derekbelsky102/kicad/README.md

Kicad cheetsheet: https://silica.io/wp-content/uploads/2018/06/kicad-cheatsheet-landscape.pdf
