derekbelsky102/kicad/hw/designs/stm32_breakout/stm32l_lqfp32/rev0/PDF/stm32l_lqfp32_rev0.pdf

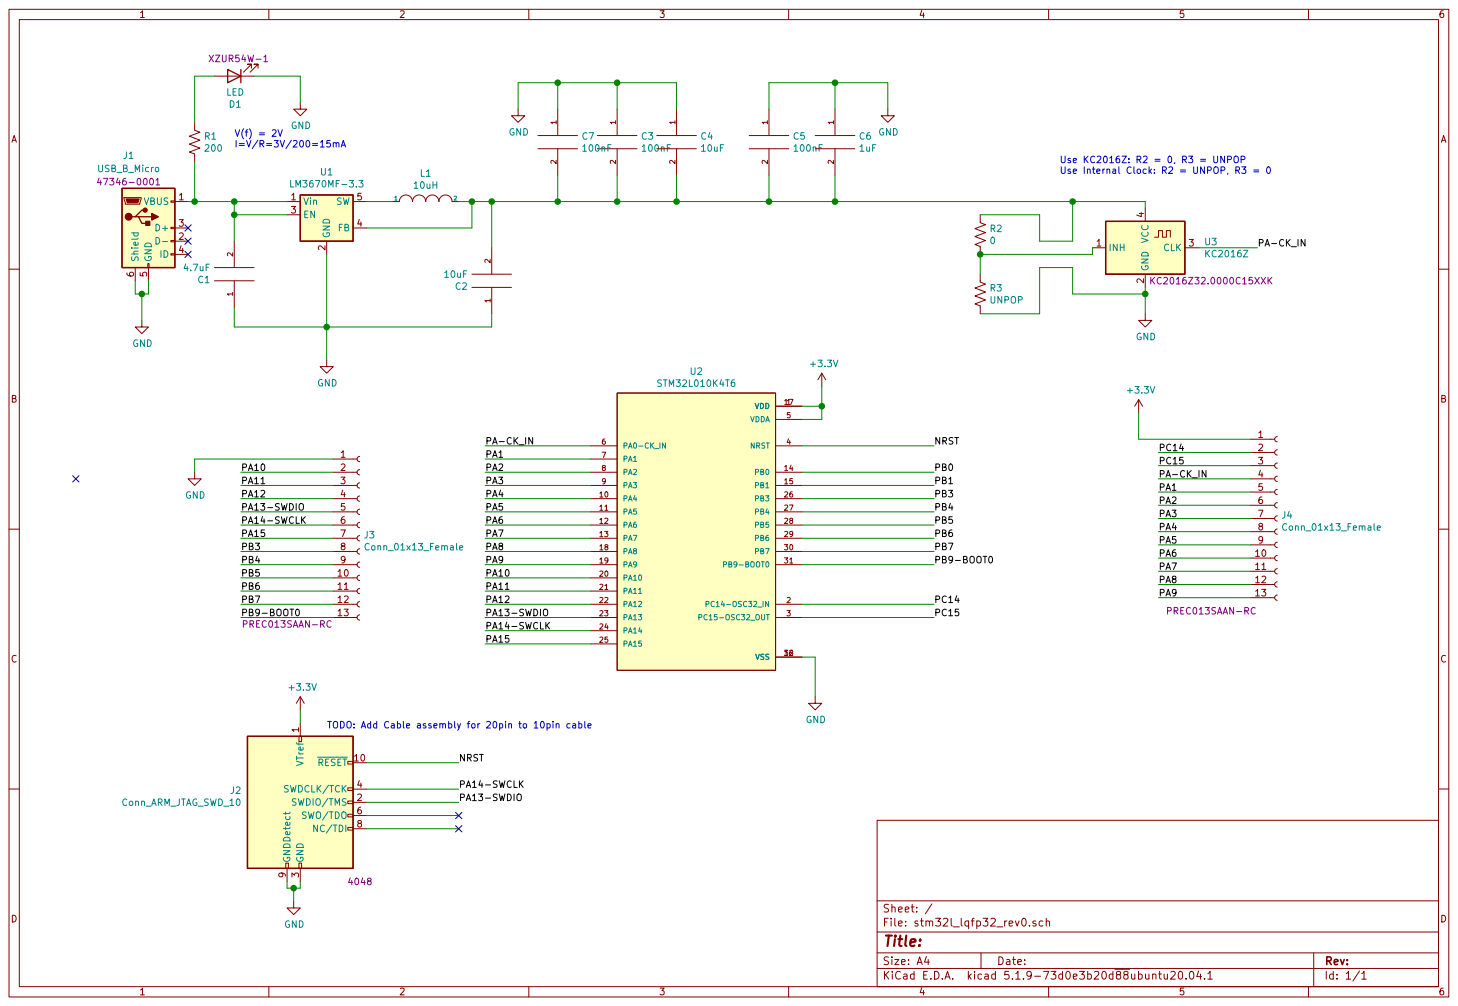
[picture p1: page 1]

TODO: Add Cable assembly for 20pin to 10pin cable

3 SWDCLK/TCK 4 SWO/TDO 6 NC/TDI 8 GNDDetect 9
