derekbelsky102/kicad/(list of files, drawings)

Other design files:
fw/docs/NUCLEO-L452RE_DEV_BOARD/Connectors.SchDoc
fw/docs/NUCLEO-L452RE_DEV_BOARD/MB1136.PcbDoc
fw/docs/NUCLEO-L452RE_DEV_BOARD/MB1136.PrjPCB
fw/docs/NUCLEO-L452RE_DEV_BOARD/MB1136.SchDoc
fw/docs/NUCLEO-L452RE_DEV_BOARD/MB1136.SCHLIB
fw/docs/NUCLEO-L452RE_DEV_BOARD/MCU_64.SchDoc
fw/docs/NUCLEO-L452RE_DEV_BOARD/ST_LINK_V2-1.SCHDOC
