derekbelsky102/kicad/hw/designs/keyboard/keyboard/keyboard.kicad_pcb

## KiCad design hw/designs/keyboard/keyboard/keyboard.kicad_pcb (2022-11-22)

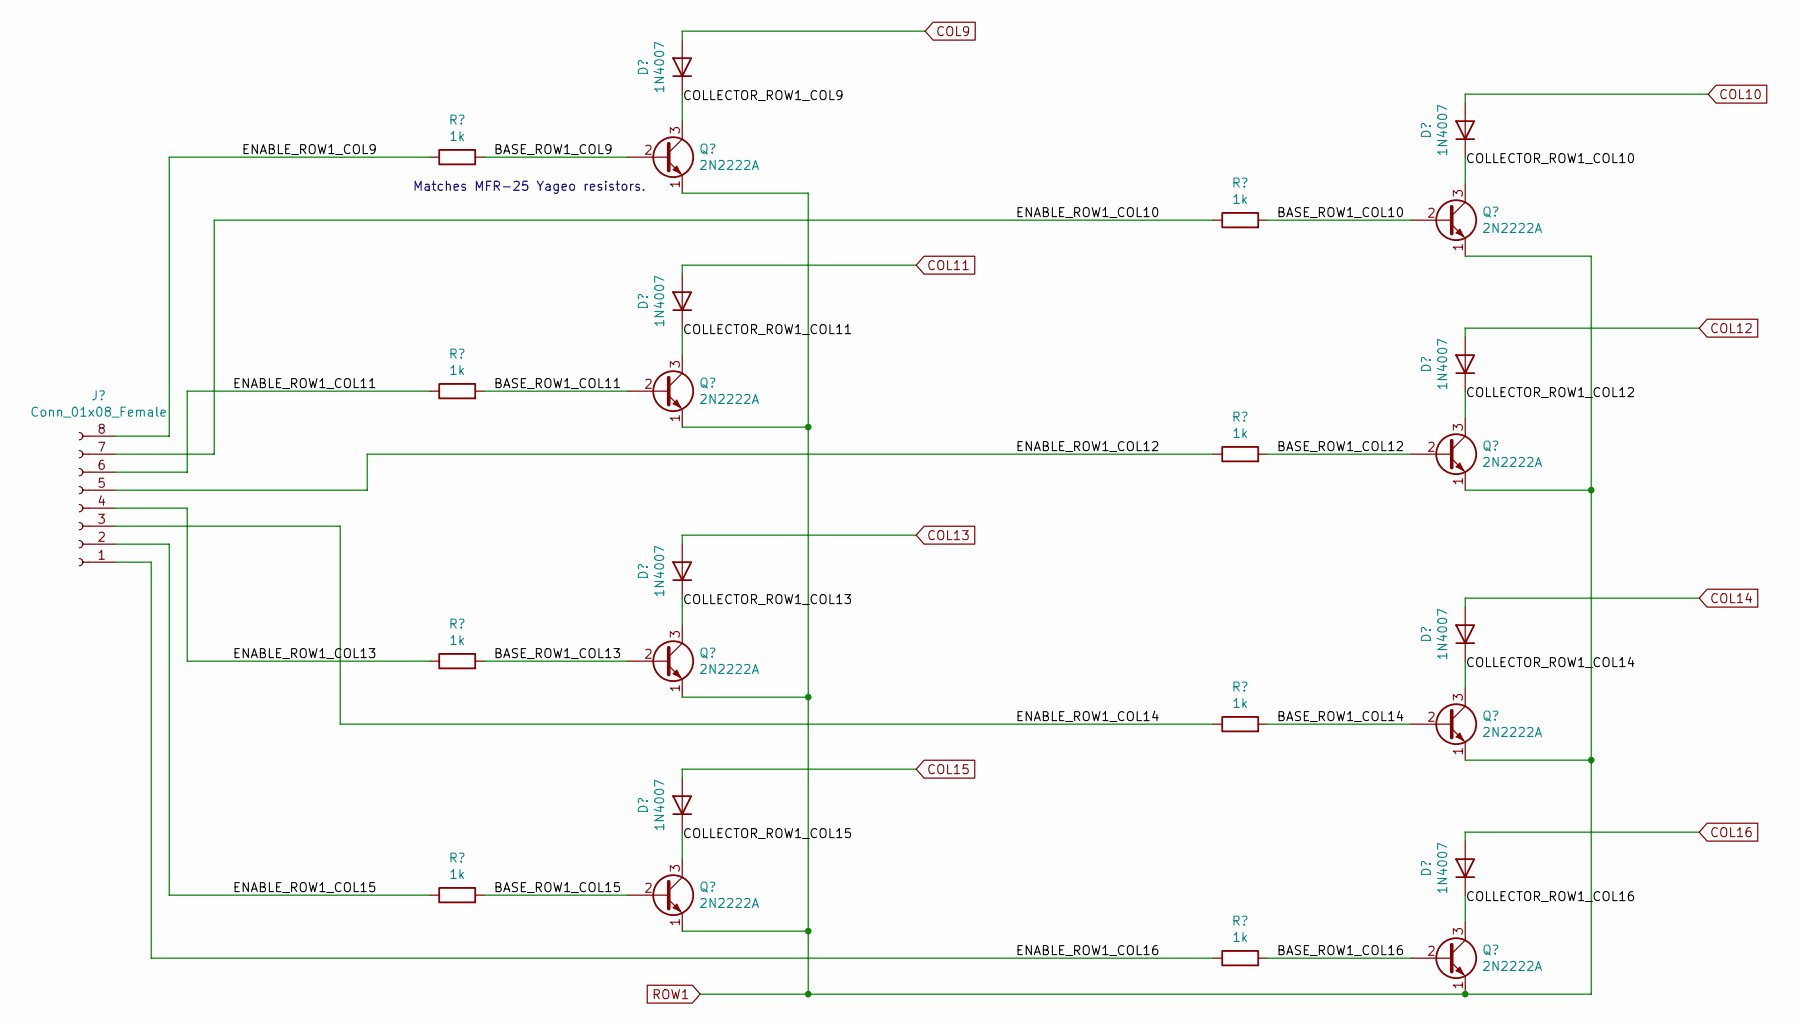
[picture p2: schematic ROW1_COL[9-16].sch]

Parts:
D9, D10, D11, D12, D13, D14, D15, D16: 1N4007; D_DO-41_SOD81_P10.16mm_Horizontal
J2: Conn_01x08_Female; PinSocket_1x08_P2.54mm_Vertical
Q9, Q10, Q11, Q12, Q13, Q14, Q15, Q16: 2N2222A; TO-92_Inline
R9, R10, R11, R12, R13, R14, R15, R16: 1k; R_Axial_DIN0207_L6.3mm_D2.5mm_P10.16mm_Horizontal

Connections:
/ROW1_COL[9-16]/BASE_ROW1_COL9: Q9.2 (B), R9.2
/ROW1_COL[9-16]/BASE_ROW1_COL10: Q13.2 (B), R13.2
/ROW1_COL[9-16]/BASE_ROW1_COL11: Q10.2 (B), R10.2
/ROW1_COL[9-16]/BASE_ROW1_COL12: Q14.2 (B), R14.2
/ROW1_COL[9-16]/BASE_ROW1_COL13: Q11.2 (B), R11.2
/ROW1_COL[9-16]/BASE_ROW1_COL14: Q15.2 (B), R15.2
/ROW1_COL[9-16]/BASE_ROW1_COL15: Q12.2 (B), R12.2
/ROW1_COL[9-16]/BASE_ROW1_COL16: Q16.2 (B), R16.2
/ROW1_COL[9-16]/COLLECTOR_ROW1_COL9: D9.1 (K), Q9.3 (C)
/ROW1_COL[9-16]/COLLECTOR_ROW1_COL10: D13.1 (K), Q13.3 (C)
/ROW1_COL[9-16]/COLLECTOR_ROW1_COL11: D10.1 (K), Q10.3 (C)
/ROW1_COL[9-16]/COLLECTOR_ROW1_COL12: D14.1 (K), Q14.3 (C)
/ROW1_COL[9-16]/COLLECTOR_ROW1_COL13: D11.1 (K), Q11.3 (C)
/ROW1_COL[9-16]/COLLECTOR_ROW1_COL14: D15.1 (K), Q15.3 (C)
/ROW1_COL[9-16]/COLLECTOR_ROW1_COL15: D12.1 (K), Q12.3 (C)
/ROW1_COL[9-16]/COLLECTOR_ROW1_COL16: D16.1 (K), Q16.3 (C)
/ROW1_COL[9-16]/ENABLE_ROW1_COL9: J2.8, R9.1
/ROW1_COL[9-16]/ENABLE_ROW1_COL10: J2.7, R13.1
/ROW1_COL[9-16]/ENABLE_ROW1_COL11: J2.6, R10.1
/ROW1_COL[9-16]/ENABLE_ROW1_COL12: J2.5, R14.1
/ROW1_COL[9-16]/ENABLE_ROW1_COL13: J2.4, R11.1
/ROW1_COL[9-16]/ENABLE_ROW1_COL14: J2.3, R15.1
/ROW1_COL[9-16]/ENABLE_ROW1_COL15: J2.2, R12.1
/ROW1_COL[9-16]/ENABLE_ROW1_COL16: J2.1, R16.1
COL9: D9.2 (A)
COL10: D13.2 (A)
COL11: D10.2 (A)
COL12: D14.2 (A)
COL13: D11.2 (A)
COL14: D15.2 (A)
COL15: D12.2 (A)
COL16: D16.2 (A)
ROW1: Q9.1 (E), Q10.1 (E), Q11.1 (E), Q12.1 (E), Q13.1 (E), Q14.1 (E), Q15.1 (E), Q16.1 (E); also elsewhere on the board

Notes on the sheet:
Matches MFR-25 Yageo resistors.

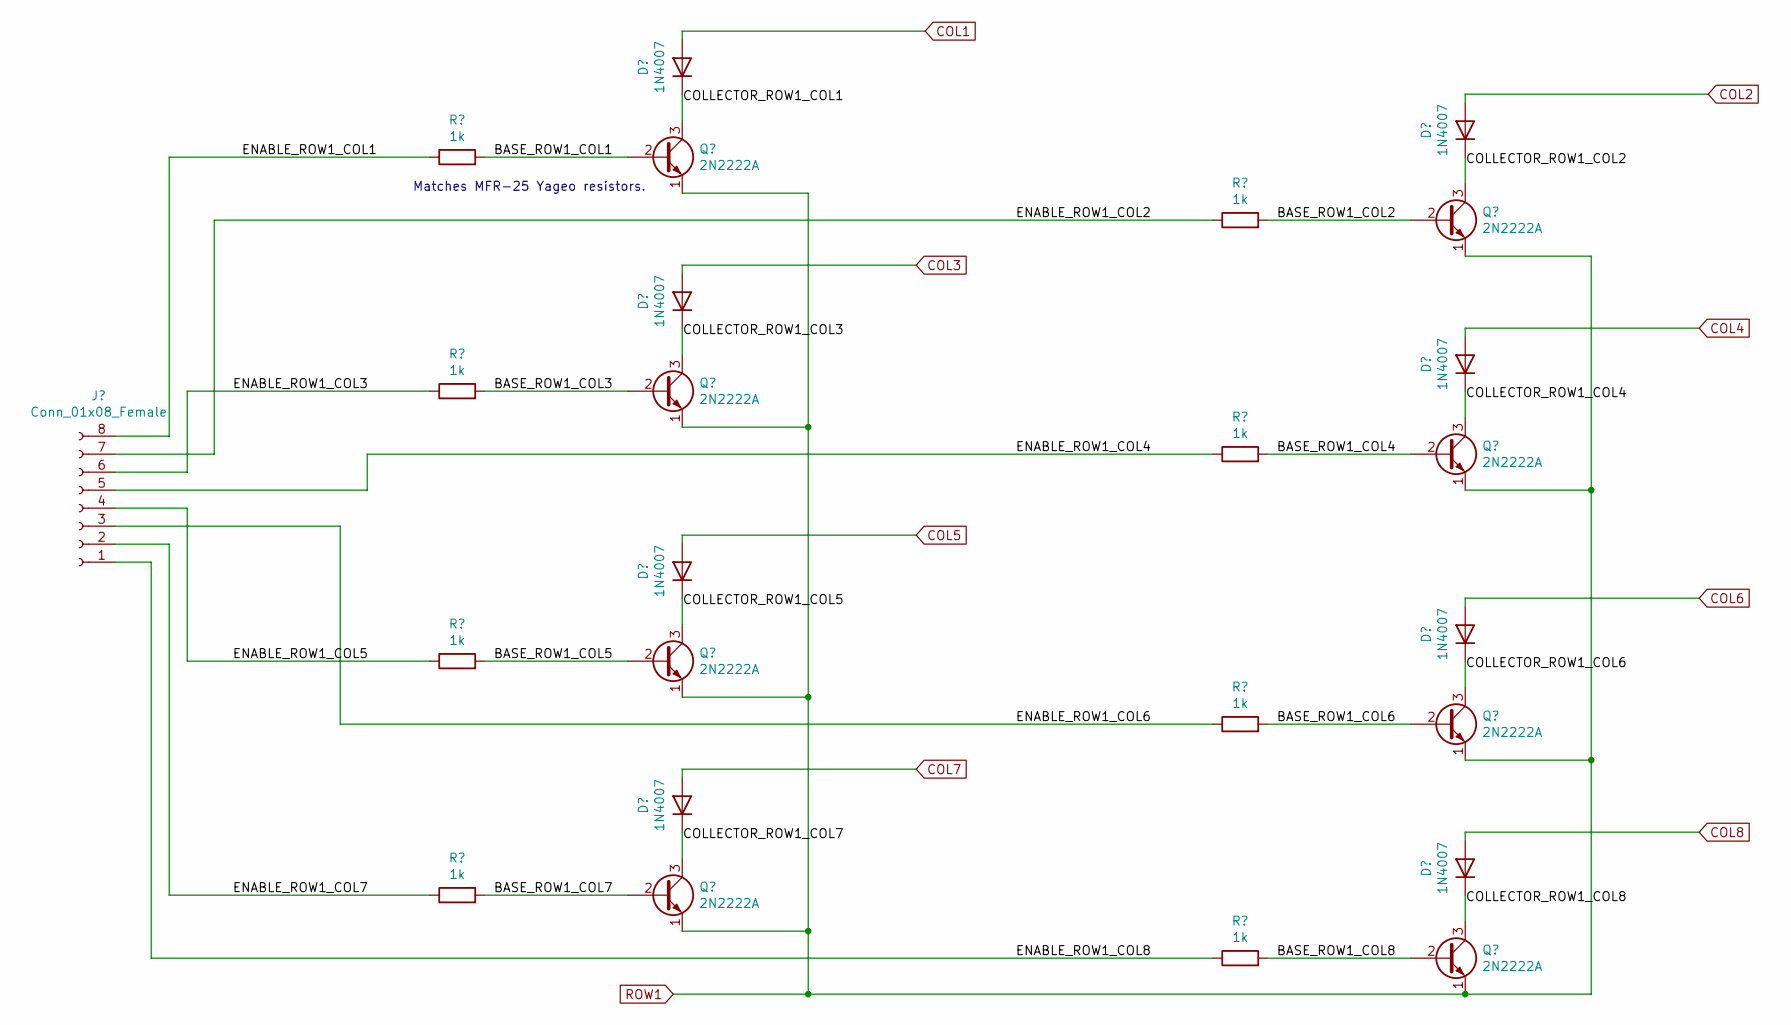
[picture p3: schematic ROW1_COL[1-8].sch]

Parts:
D1, D2, D3, D4, D5, D6, D7, D8: 1N4007; D_DO-41_SOD81_P10.16mm_Horizontal
J1: Conn_01x08_Female; PinSocket_1x08_P2.54mm_Vertical
Q1, Q2, Q3, Q4, Q5, Q6, Q7, Q8: 2N2222A; TO-92_Inline
R1, R2, R3, R4, R5, R6, R7, R8: 1k; R_Axial_DIN0207_L6.3mm_D2.5mm_P10.16mm_Horizontal

Connections:
/ROW1_COL[1-8]/BASE_ROW1_COL1: Q1.2 (B), R1.2
/ROW1_COL[1-8]/BASE_ROW1_COL2: Q5.2 (B), R5.2
/ROW1_COL[1-8]/BASE_ROW1_COL3: Q2.2 (B), R2.2
/ROW1_COL[1-8]/BASE_ROW1_COL4: Q6.2 (B), R6.2
/ROW1_COL[1-8]/BASE_ROW1_COL5: Q3.2 (B), R3.2
/ROW1_COL[1-8]/BASE_ROW1_COL6: Q7.2 (B), R7.2
/ROW1_COL[1-8]/BASE_ROW1_COL7: Q4.2 (B), R4.2
/ROW1_COL[1-8]/BASE_ROW1_COL8: Q8.2 (B), R8.2
/ROW1_COL[1-8]/COLLECTOR_ROW1_COL1: D1.1 (K), Q1.3 (C)
/ROW1_COL[1-8]/COLLECTOR_ROW1_COL2: D5.1 (K), Q5.3 (C)
/ROW1_COL[1-8]/COLLECTOR_ROW1_COL3: D2.1 (K), Q2.3 (C)
/ROW1_COL[1-8]/COLLECTOR_ROW1_COL4: D6.1 (K), Q6.3 (C)
/ROW1_COL[1-8]/COLLECTOR_ROW1_COL5: D3.1 (K), Q3.3 (C)
/ROW1_COL[1-8]/COLLECTOR_ROW1_COL6: D7.1 (K), Q7.3 (C)
/ROW1_COL[1-8]/COLLECTOR_ROW1_COL7: D4.1 (K), Q4.3 (C)
/ROW1_COL[1-8]/COLLECTOR_ROW1_COL8: D8.1 (K), Q8.3 (C)
/ROW1_COL[1-8]/ENABLE_ROW1_COL1: J1.8, R1.1
/ROW1_COL[1-8]/ENABLE_ROW1_COL2: J1.7, R5.1
/ROW1_COL[1-8]/ENABLE_ROW1_COL3: J1.6, R2.1
/ROW1_COL[1-8]/ENABLE_ROW1_COL4: J1.5, R6.1
/ROW1_COL[1-8]/ENABLE_ROW1_COL5: J1.4, R3.1
/ROW1_COL[1-8]/ENABLE_ROW1_COL6: J1.3, R7.1
/ROW1_COL[1-8]/ENABLE_ROW1_COL7: J1.2, R4.1
/ROW1_COL[1-8]/ENABLE_ROW1_COL8: J1.1, R8.1
COL1: D1.2 (A)
COL2: D5.2 (A)
COL3: D2.2 (A)
COL4: D6.2 (A)
COL5: D3.2 (A)
COL6: D7.2 (A)
COL7: D4.2 (A)
COL8: D8.2 (A)
ROW1: Q1.1 (E), Q2.1 (E), Q3.1 (E), Q4.1 (E), Q5.1 (E), Q6.1 (E), Q7.1 (E), Q8.1 (E); also elsewhere on the board

Notes on the sheet:
Matches MFR-25 Yageo resistors.

Board: 2 copper layers, 50 parts (0 on the bottom side), 49 nets, no tracks yet.
