derekbelsky102/kicad/hw/designs/stm32_breakout/stm32l_tssop20/rev0/stm32_breakout.kicad_pcb

## KiCad design hw/designs/stm32_breakout/stm32l_tssop20/rev0/stm32_breakout.kicad_pcb (2021-07-11, an earlier design)

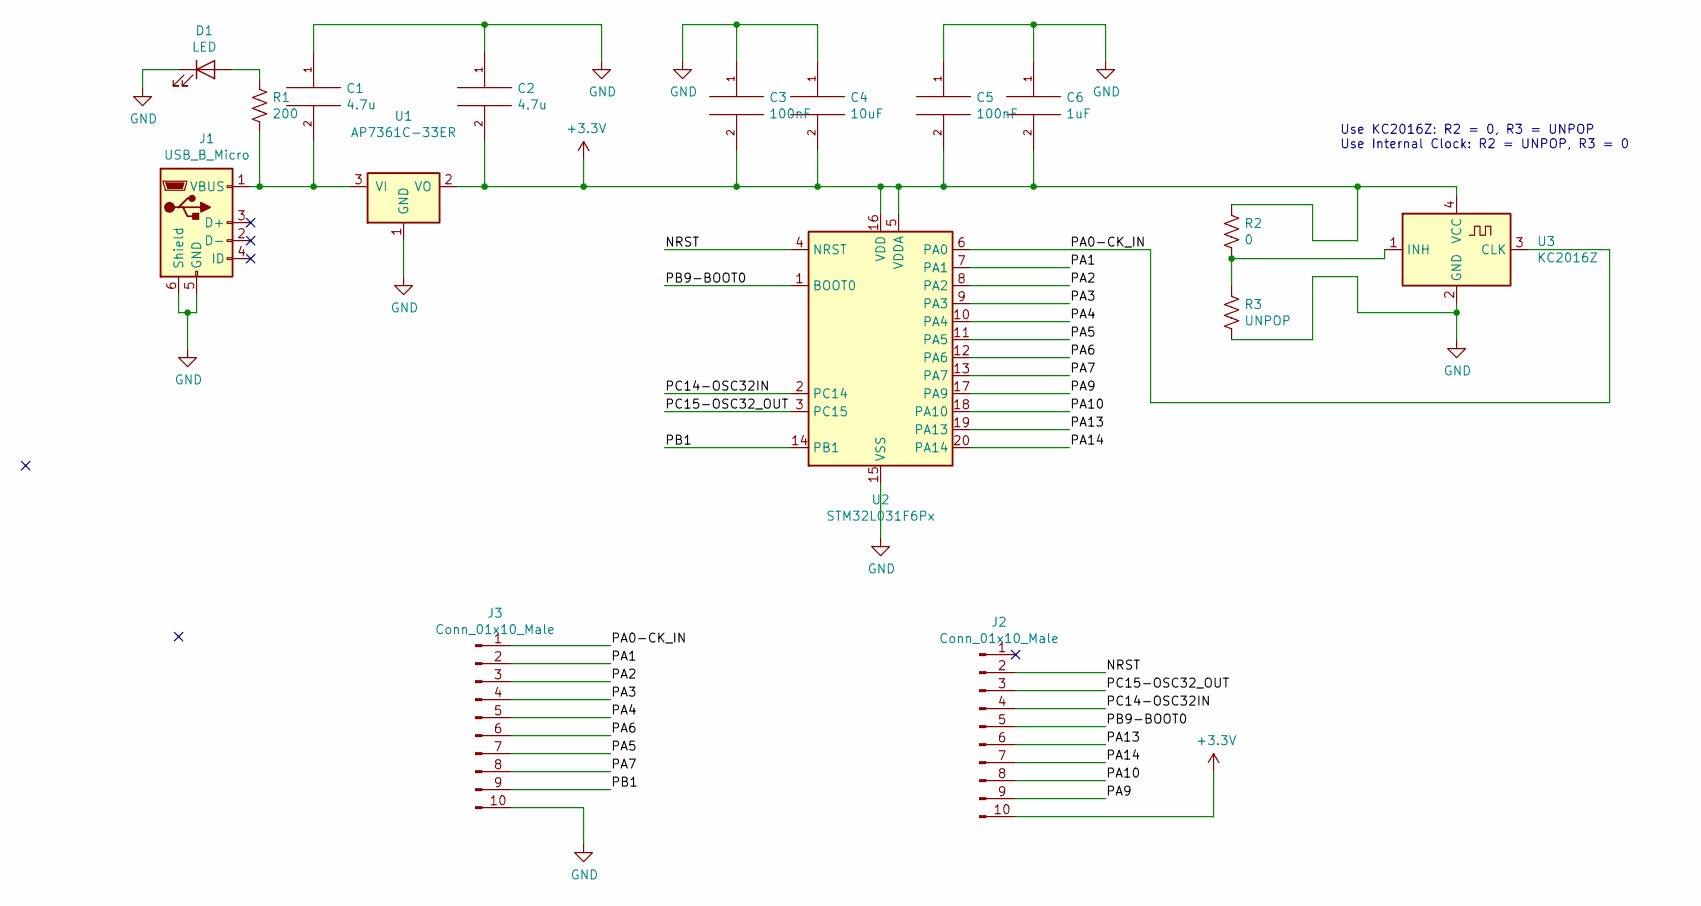
[picture p4: schematic stm32_breakout.sch]

Parts:
C1, C2: 4.7u; C_0805_2012Metric
C3, C5: 100nF; C_0805_2012Metric
C4: 10uF; C_0805_2012Metric
C6: 1uF; C_0805_2012Metric
D1: LED; LED_0805_2012Metric
J1: USB_B_Micro; USB_Micro-B_Molex_47346-0001
J2, J3: Conn_01x10_Male; PinSocket_1x10_P2.54mm_Vertical
R1: 200; R_0805_2012Metric
R2: 0; R_0805_2012Metric
R3: UNPOP; R_0805_2012Metric
U1: AP7361C-33ER; SOT-223-3_TabPin2
U2: STM32L031F6Px; TSSOP-20_4.4x6.5mm_P0.65mm
U3: KC2016Z

Connections:
+3V3: C2.2, C3.2, C4.2, C5.2, C6.2, J2.10, R2.1, U1.2 (VO), U2.5 (VDDA), U2.16 (VDD), U3.4 (VCC)
/NRST: J2.2, U2.4 (NRST)
/PA0-CK_IN: J3.1, U2.6 (PA0), U3.3 (CLK)
/PA1: J3.2, U2.7 (PA1)
/PA2: J3.3, U2.8 (PA2)
/PA3: J3.4, U2.9 (PA3)
/PA4: J3.5, U2.10 (PA4)
/PA5: J3.7, U2.11 (PA5)
/PA6: J3.6, U2.12 (PA6)
/PA7: J3.8, U2.13 (PA7)
/PA9: J2.9, U2.17 (PA9)
/PA10: J2.8, U2.18 (PA10)
/PA13: J2.6, U2.19 (PA13)
/PA14: J2.7, U2.20 (PA14)
/PB1: J3.9, U2.14 (PB1)
/PB9-BOOT0: J2.5, U2.1 (BOOT0)
/PC14-OSC32IN: J2.4, U2.2 (PC14)
/PC15-OSC32_OUT: J2.3, U2.3 (PC15)
GND: C1.1, C2.1, C3.1, C4.1, C5.1, C6.1, D1.1 (K), J1.5 (GND), J1.6 (Shield), J3.10, R3.2, U1.1 (GND), U2.15 (VSS), U3.2 (GND)
unnamed: C1.2, J1.1 (VBUS), R1.2, U1.3 (VI)
unnamed: D1.2 (A), R1.1
unnamed: R2.2, R3.1, U3.1 (INH)

Notes on the sheet:
Use KC2016Z: R2 = 0, R3 = UNPOP Use Internal Clock: R2 = UNPOP, R3 = 0

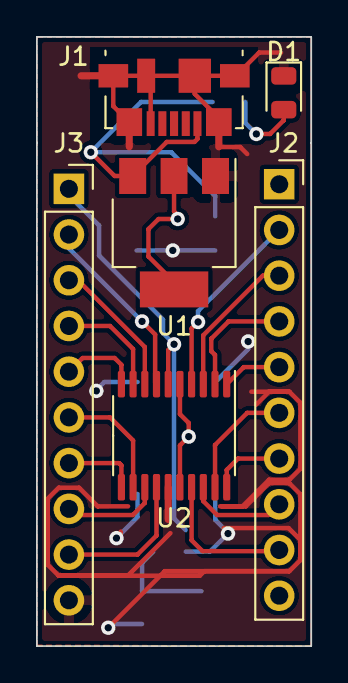
[picture p5: board stm32_breakout.kicad_pcb from above]

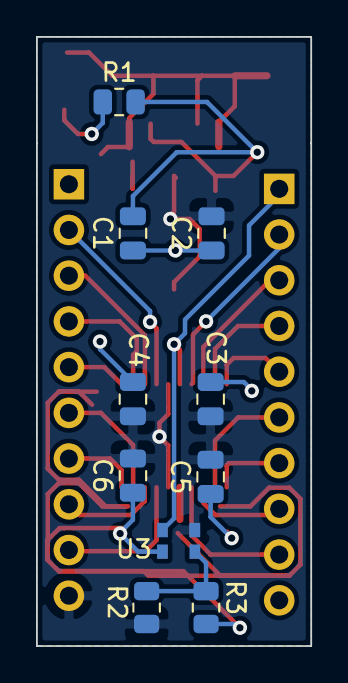
[picture p6: board stm32_breakout.kicad_pcb from below]

Board: 2 copper layers, 15.2 x 33.8 mm, 16 parts (10 on the bottom side), 22 nets.
