derekbelsky102/kicad/hw/designs/stm32_breakout/stm32l_lqfp32/rev0/stm32l_lqfp32_rev0.sch

## KiCad design hw/designs/stm32_breakout/stm32l_lqfp32/rev0/stm32l_lqfp32_rev0.sch (2021-10-27)

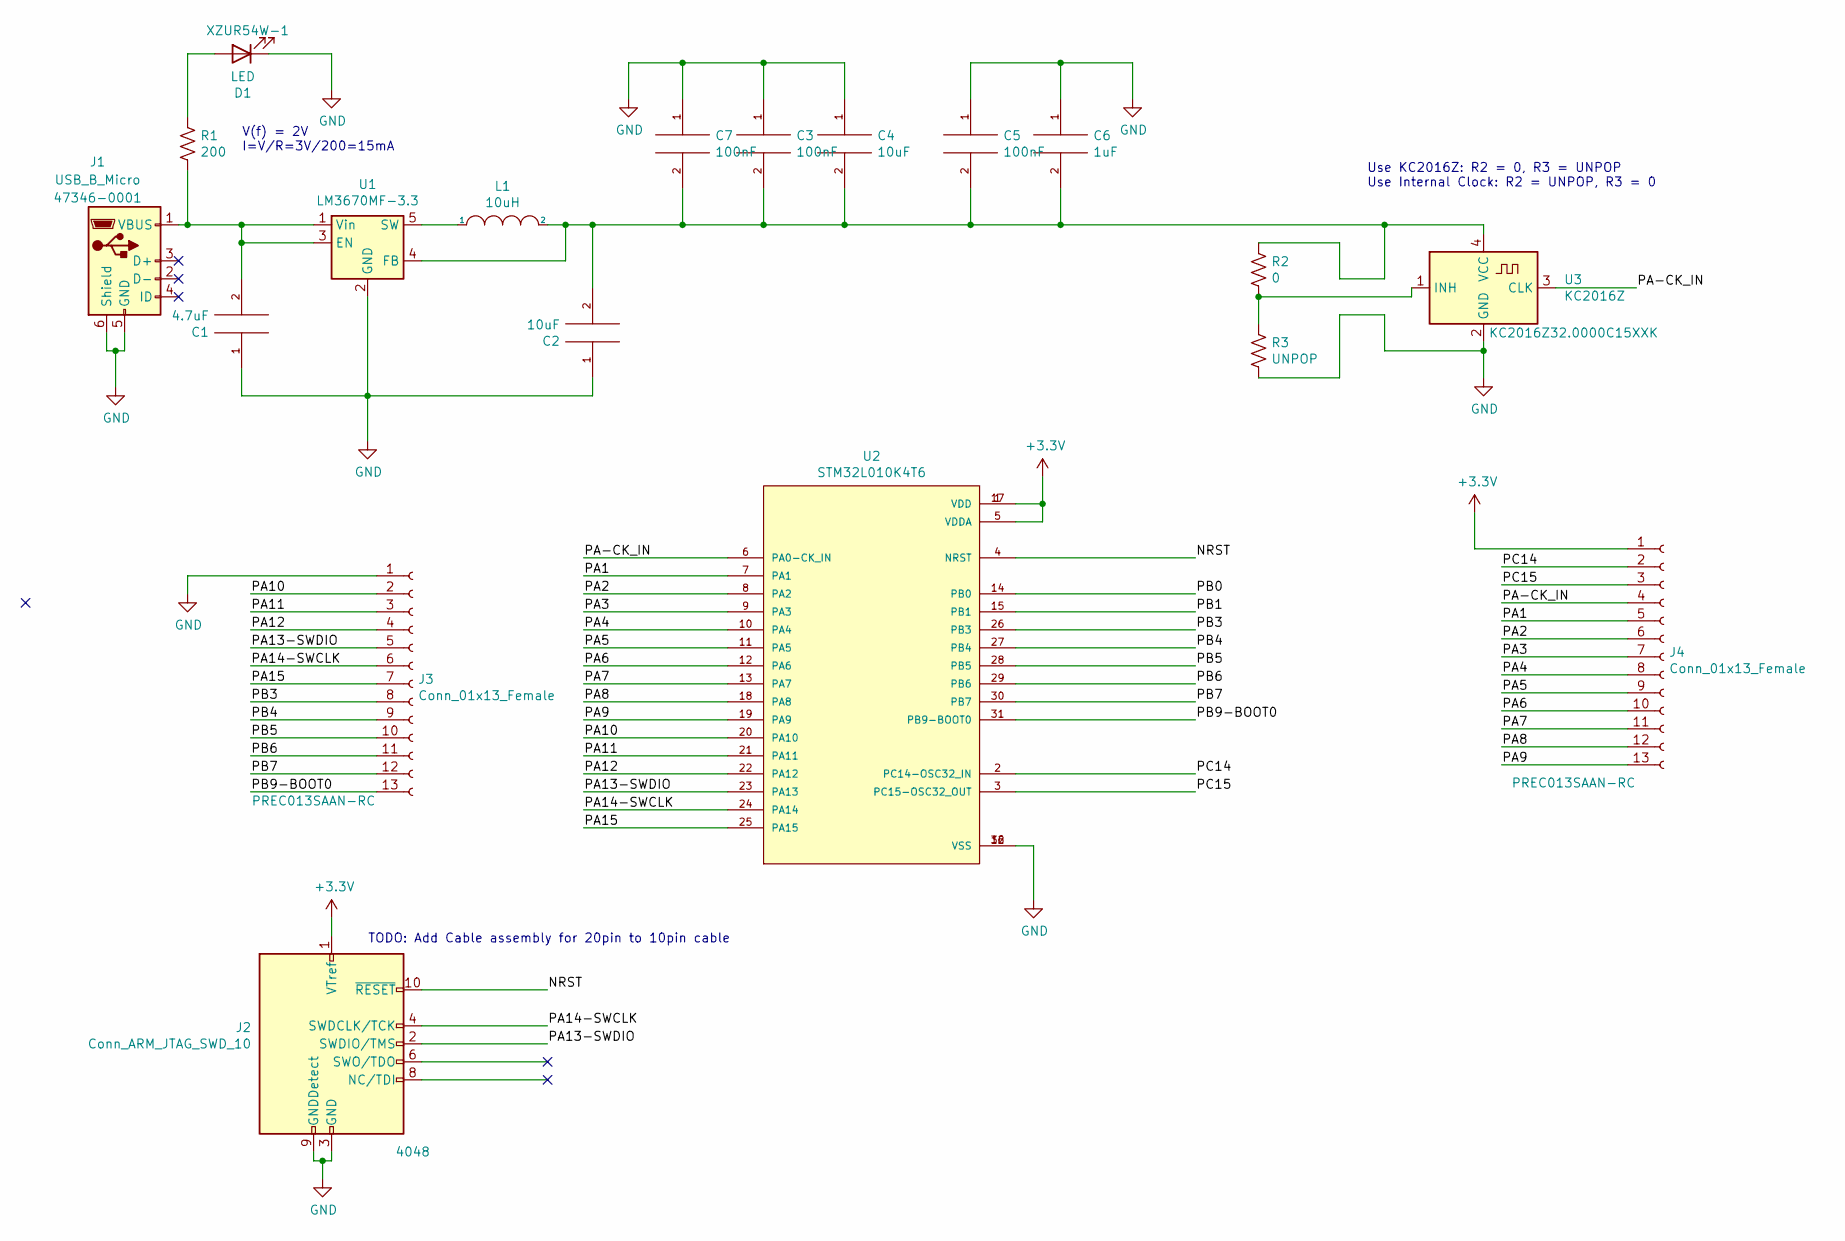
[picture p7: schematic stm32l_lqfp32_rev0.sch]

Parts:
C1: 4.7uF; C_0805_2012Metric; Part_Number TMK212ABJ475MG-T
C2, C4: 10uF; C_0805_2012Metric; Part_Number JMK212ABJ106KG-T
C3, C5, C7: 100nF; C_0805_2012Metric; Part_Number CGA4J2X7R2A104K125AA
C6: 1uF; C_0805_2012Metric; Part_Number C0805C105M8RACAUTO
D1: LED; LED_0805_2012Metric; Part_Number XZUR54W-1
J1: USB_B_Micro; USB_Micro-B_Molex_47346-0001; Part_Number 47346-0001
J2: Conn_ARM_JTAG_SWD_10; 2X05_1.27MM_BOX_POSTS; Part_Number 4048
J3, J4: Conn_01x13_Female; PinHeader_1x13_P2.54mm_Vertical; Part_Number PREC013SAAN-RC
L1: 10uH; L_1210_3225Metric_Pad1.42x2.65mm_HandSolder; Part_Number LB3218T100K
R1: 200; R_0805_2012Metric; Part_Number ERJ-PB6D2000V
R2: 0; R_0805_2012Metric; Part_Number RCS08050000Z0EA
R3: UNPOP; R_0805_2012Metric; Part_Number UNPOP
U1: LM3670MF-3.3; TSOT-23-5; Part_Number LM3670MF-3.3
U2: STM32L010K4T6; QFP80P900X900X160-32N; Part_Number STM32L010K4T6
U3: KC2016Z; Part_Number KC2016Z32.0000C15XXK

Connections:
+3.3V: J2.1 (VTref), J4.1, U2.1 (VDD), U2.5 (VDDA), U2.17 (VDD)
GND: C1.1, C2.1, C3.1, C4.1, C5.1, C6.1, C7.1, D1.1 (K), J1.5 (GND), J1.6 (Shield), J2.3 (GND), J2.5 (GND), J2.9 (GNDDetect), J3.1, R3.2, U1.2 (GND), U2.16 (VSS), U2.32 (VSS), U3.2 (GND)
NRST: J2.10 (~RESET~), U2.4 (NRST)
unnamed: C1.2, J1.1 (VBUS), R1.2, U1.1 (Vin), U1.3 (EN)
unnamed: C2.2, C3.2, C4.2, C5.2, C6.2, C7.2, L1.2, R2.1, U1.4 (FB), U3.4 (VCC)
unnamed: D1.2 (A), R1.1
unnamed: L1.1, U1.5 (SW)
unnamed: R2.2, R3.1, U3.1 (INH)
PA1: J4.5, U2.7 (PA1)
PA2: J4.6, U2.8 (PA2)
PA3: J4.7, U2.9 (PA3)
PA4: J4.8, U2.10 (PA4)
PA5: J4.9, U2.11 (PA5)
PA6: J4.10, U2.12 (PA6)
PA7: J4.11, U2.13 (PA7)
PA8: J4.12, U2.18 (PA8)
PA9: J4.13, U2.19 (PA9)
PA10: J3.2, U2.20 (PA10)
PA11: J3.3, U2.21 (PA11)
PA12: J3.4, U2.22 (PA12)
PA13-SWDIO: J2.2 (SWDIO/TMS), J3.5, U2.23 (PA13)
PA14-SWCLK: J2.4 (SWDCLK/TCK), J3.6, U2.24 (PA14)
PA15: J3.7, U2.25 (PA15)
PA-CK_IN: J4.4, U2.6 (PA0-CK_IN), U3.3 (CLK)
PB0: U2.14 (PB0)
PB1: U2.15 (PB1)
PB3: J3.8, U2.26 (PB3)
PB4: J3.9, U2.27 (PB4)
PB5: J3.10, U2.28 (PB5)
PB6: J3.11, U2.29 (PB6)
PB7: J3.12, U2.30 (PB7)
PB9-BOOT0: J3.13, U2.31 (PB9-BOOT0)
PC14: J4.2, U2.2 (PC14-OSC32_IN)
PC15: J4.3, U2.3 (PC15-OSC32_OUT)

Notes on the sheet:
Use KC2016Z: R2 = 0, R3 = UNPOP Use Internal Clock: R2 = UNPOP, R3 = 0
V(f) = 2V I=V/R=3V/200=15mA
TODO: Add Cable assembly for 20pin to 10pin cable
