derekbelsky102/kicad/(threads)

Thread 1 (2021-09-12):

Look into BOM format

adamyosua, 2021-09-12:
I want to be able to easily order these parts. I tried creating a BOM within eeschema but it seems like they are plugins that need some effort to get to work and render the digikey links. There is also a digikey list that I can make which seems helpful but I don't think I can share it publicly. I can export to csv if need be.

In this issue I should figure out the best way to handle it.

adamyosua, 2021-09-12:
For now I am just going to manually make a digikey list by looking at the schematic.

Thread 2 (2021-09-18):

Connection Issues with STLink

derekbelsky102, 2021-09-18:
Sometimes connection can be established but connection is quickly loss.

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

I would like to create a 20->10 pin adapter that plugs into STLink and a connector on the board. This will require another rev of the board. The problem still occurs when specifying lower frequencies like 15kHz so it may not be an issue with the breadboard setup.

The TSSOP 20 package is all sold out on digikey so if another board was going to be made it would have to be for a different part. One proposed part: https://www.digikey.com/en/products/detail/stmicroelectronics/STM32L031K6T6TR/6621794

Something else that might be wrong is the capacitor values between VDD and GND or there could be missing resistors in the circuit. I am going to look into this to see if this is the problem before working towards a different board.

derekbelsky102, 2021-09-26:
On the board, I was testing NRST was 0V and it should be 3.3V

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

derekbelsky102, 2021-09-26:
I think there might be something wrong with the stm32 chip I have installed in the breakout board right now. Unfortunately I don't have any more of that specific microcontroller and all microcontrollers of the 20-TSSOP package are sold out right on digikey:

https://www.digikey.com/en/products/filter/embedded-microcontrollers/685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

My plan going forward is to buy a bunch of another package and build another breakout board based off whatever part is available but isn't that large of a package.

Some improvements I plan on including in this next board:
Adding header for programming board. There are some 10 pin headers that might work best.
Fixing clocking footprint. In last revision it was discovered that clock part was actually mirrored so it couldn't be used.

adamyosua, 2021-09-26:
I haven’t used any of my stm32s yet. If you want I could give you some. Perhaps we should start an order from digikey as well. I have a feeling that whatever we switch to will also go out of stock soon. Doesn’t mean I think we shouldn’t try to switch.

Doesn't hurt to try a couple of different angles.

derekbelsky102, 2021-09-27:
I just bought Qty 25 of the following stm32 part.

https://www.digikey.com/en/products/detail/stmicroelectronics/STM32L010K4T6/9770447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

The next board with include this part with the improvement I listed in the previous comment.

Thread 4 (2021-11-01):

LFQP STM32 Schematic review discussion

adamyosua, 2021-11-01:
This issue is just to document the discussion centered around the schematic review of the design with the alternate stm32 lfqp package.

adamyosua, 2021-11-01:
Here are my raw notes. I will clean the up soon....

Notes

- No datasheets linked in schematics (not sure if it is possible)
	- check in chrome on windows. See if this is even a feature in kicad.
- part number in BOM digikey or manufacturer?
        it is manufacturer
- Vss ref on stm32 looks weird?
	ignore for now
- 3v3 is the output of U1 but doesn't appear to be labeled that way.
	- add 3v3 pwr net
- To give the clock High and low signals do you need a current limiting resistor?
	- look into this
- Are we able to reset the micro easily or should NRST go to a gpio connector
	add a button.
- Do we want the extra inductor and capacitors for VDDA? (Section 6.16 on the stm32l0 datasheet)
- What are the puff capacitors on the oscillator for?
- Pin 5 on J2 should be connected to ground?
DONE
- Verify regulator is setup properly
	- This looks good to me.
- check that the clock is setup properly
	- This looks good except for the note I made.
- verify LED won't blow

TO DO
- check against stm32 ref design (Getting started with the stm32l0xx)
- Check that all the pins are connected to connectors
- you can program the chip
