derekbelsky102/kicad/(commit log)

2021-04-02 Completed video 1 of the tutorial
    [christmas_bauble.kicad_pcb, christmas_bauble.sch]
2021-04-02 Added pull down resistors. Now video 1 is complete
    [christmas_bauble.sch]
2021-04-19 Initial schematic
    [stm32_breakout.kicad_pcb, stm32_breakout.sch]
2021-04-22 Added clocking and jumpers
    [stm32_breakout.sch]
2021-04-25 Updated to 32K flash and replaced resistor with jumper. Also added Nucleo reference material
    [Connectors.SchDoc, MB1136.PcbDoc, MB1136.PrjPCB, MB1136.SCHLIB, MB1136.SchDoc, MCU_64.SchDoc, ST_LINK_V2-1.SCHDOC, stm32_breakout.sch]
2021-04-25 Added bypass caps to the voltage regulator.
    [stm32_breakout.sch]
2021-05-05 Added LED, annotated schematic, and ERC is passing
    [stm32_breakout.sch]
2021-05-05 All parts except KC2016Z are associated with footprints now
    [stm32_breakout.sch]
2021-05-30 Added KC2016 footprint
    [stm32_breakout.sch]
2021-05-30 Started routing. Some changes will need to be made to schematic
    [stm32_breakout.kicad_pcb]
2021-05-31 Removed RTC circuit. Changed pinout on headers. Updated jumpers to resistors instead. Started routing
    [stm32_breakout.kicad_pcb, stm32_breakout.sch]
2021-05-31 Routing complete except for 3V3 and GND
    [stm32_breakout.kicad_pcb]
2021-05-31 Board is complete. Needs review
    [stm32_breakout.kicad_pcb]
2021-05-31 Just pushing in case some changes didn't make it in
    [stm32_breakout.kicad_pcb, stm32_breakout.sch]
2021-05-31 Attempt to switch the pinout of the regulator part. Made a new project specific library called Adek lib
    [stm32_breakout.sch]
2021-05-31 Updated PCB to address SOT223R part change
    [stm32_breakout.kicad_pcb]
2021-07-11 Moving everything to rev0 because another rev will be needed
    [stm32_breakout-B_Cu.gbr, stm32_breakout-B_Mask.gbr, stm32_breakout-B_Paste.gbr, stm32_breakout-B_SilkS.gbr, stm32_breakout-Edge_Cuts.gbr, stm32_breakout-F_Cu.gbr, stm32_breakout-F_Mask.gbr, stm32_breakout-F_Paste.gbr]
2021-07-13 Added fab outputs
    [stm32_breakout-B_Cu.gbr, stm32_breakout-B_Mask.gbr, stm32_breakout-B_Paste.gbr, stm32_breakout-B_SilkS.gbr, stm32_breakout-Edge_Cuts.gbr, stm32_breakout-F_Cu.gbr, stm32_breakout-F_Mask.gbr, stm32_breakout-F_Paste.gbr]
2021-09-12 Added a git ignore file after a brief search for one for kicad projects. It looks like it should do the trick for now.
2021-09-12 untrack files in kicad.gitignore. Please see the stack overflow post that I link below if you are still having issues with ignored files showing up. Most likely running the commands in the linked sta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
2021-09-26 Updated with SWD pins
    [stm32_breakout.sch]
2021-09-26 Moving files to tssop20 folder
    [stm32_breakout-B_Cu.gbr, stm32_breakout-B_Mask.gbr, stm32_breakout-B_Paste.gbr, stm32_breakout-B_SilkS.gbr, stm32_breakout-Edge_Cuts.gbr, stm32_breakout-F_Cu.gbr, stm32_breakout-F_Mask.gbr, stm32_breakout-F_Paste.gbr]
2021-09-27 Started new schematic with LQFP-32 part
    [stm32l_lqfp32_rev0.sch]
2021-10-07 Updated with 13 pin connector and 10pin SWD connector.
2021-10-27 Updated with BOM and PDF folders
    [stm32l_lqfp32_rev0.csv, stm32l_lqfp32_rev0.sch]
2021-10-27 Updated KC2016Z and part for 10 pin header
2021-10-27 Updated KC2016Z part but didn't push in last commit
    [stm32l_lqfp32_rev0.csv]
2021-10-27 Part number was missing for inductor
    [stm32l_lqfp32_rev0.sch]
2021-10-27 Updated BOM with inductor part
    [stm32l_lqfp32_rev0.csv]
2021-11-04 Adding symbols for another design
    [atmega32_to_oled.kicad_pcb, atmega32_to_oled.sch]
2022-11-20 One page of schematic
    [keyboard.kicad_pcb, keyboard.sch]
2022-11-22 Adding sheets
    [ROW1_COL[1-8].sch, ROW1_COL[9-16].sch, keyboard.kicad_pcb, keyboard.sch]
